rdbisch/cs498_final_project/3078-05.jpg

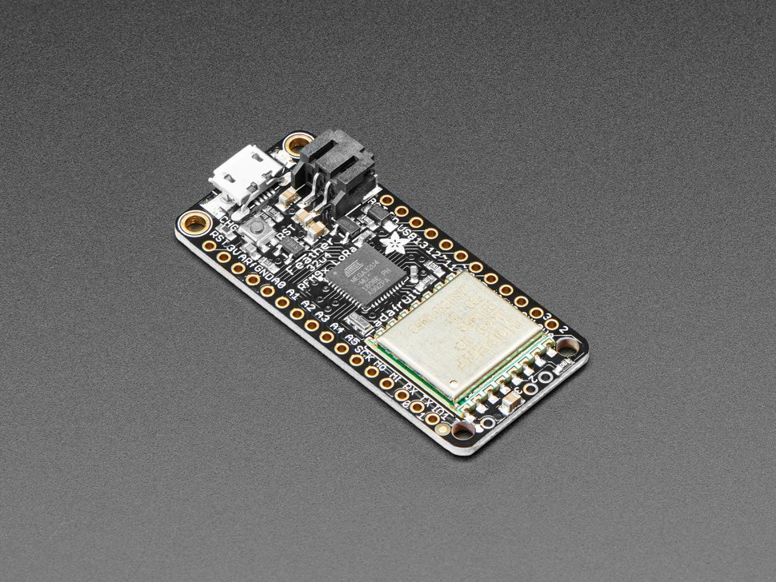
3078-05.jpg
