rdbisch/cs498_final_project/169-06.jpg

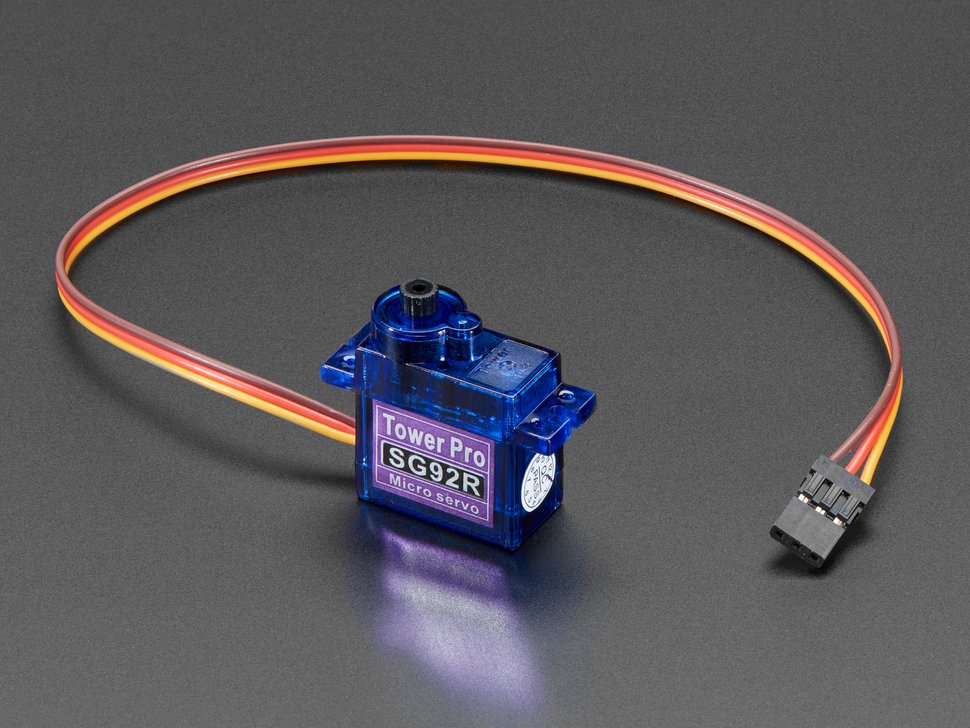
169-06.jpg
