rdbisch/cs498_final_project/data/README.md

Required directory for thermostat data logging.
