rdbisch/cs498_final_project/20210511_071446_thumb.png

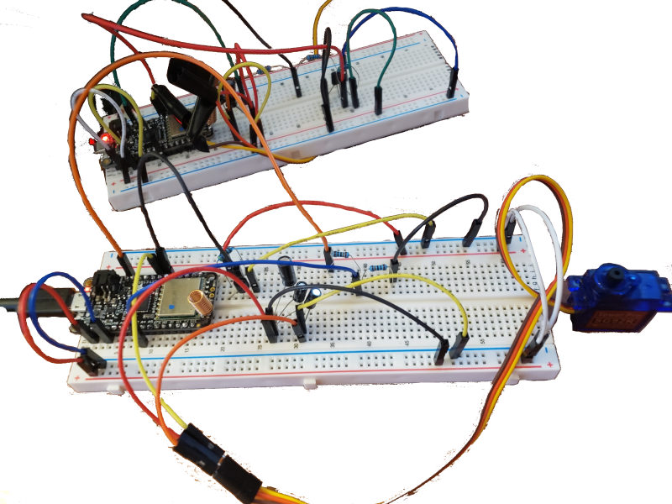
20210511_071446_thumb.png
