rdbisch/cs498_final_project/20210511_173217.jpg

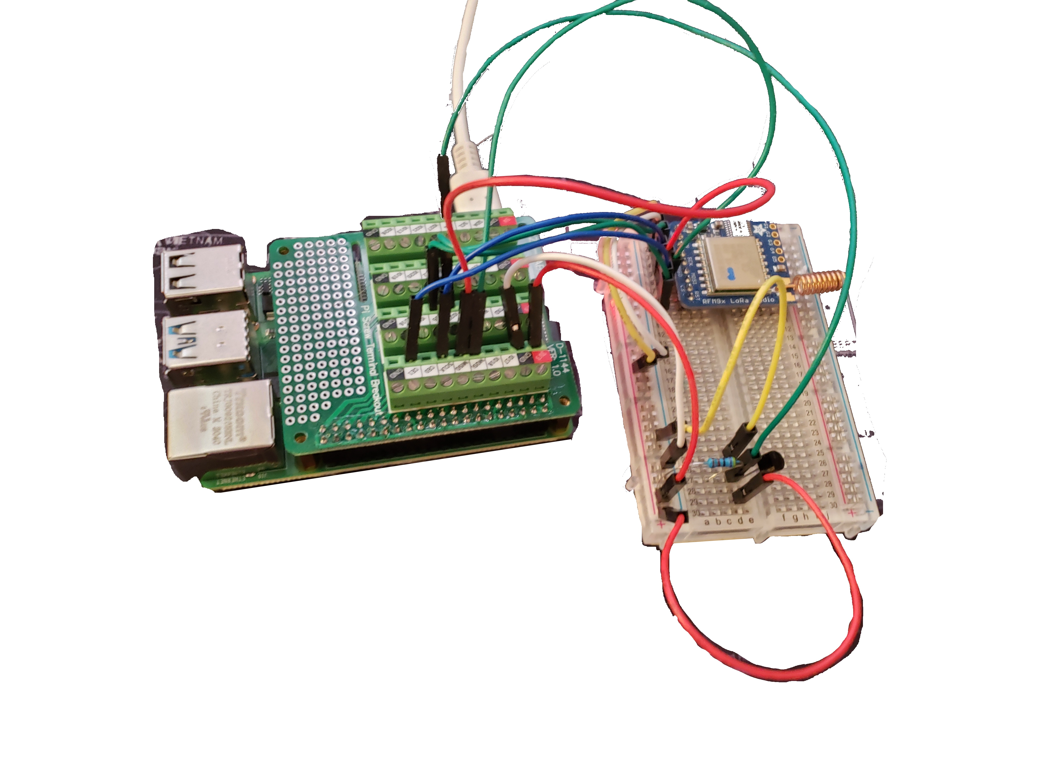
20210511_173217.jpg
