rdbisch/cs498_final_project/AltForcedAir.png

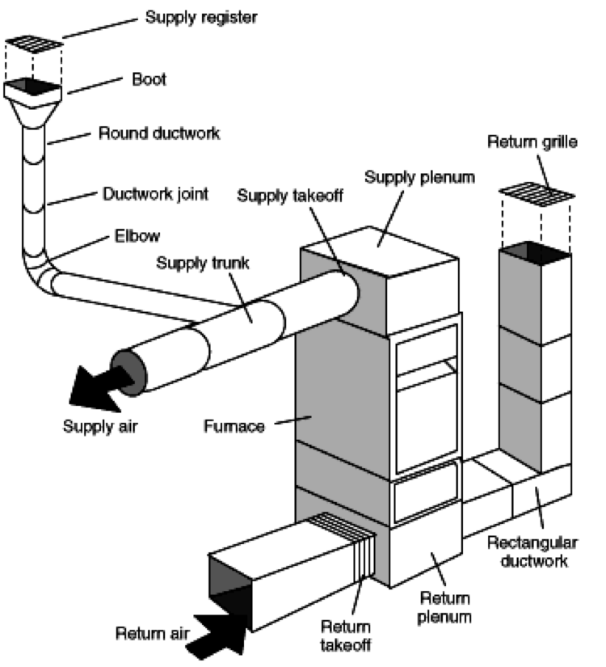
AltForcedAir.png
