rdbisch/cs498_final_project/analysis/no_corr.png

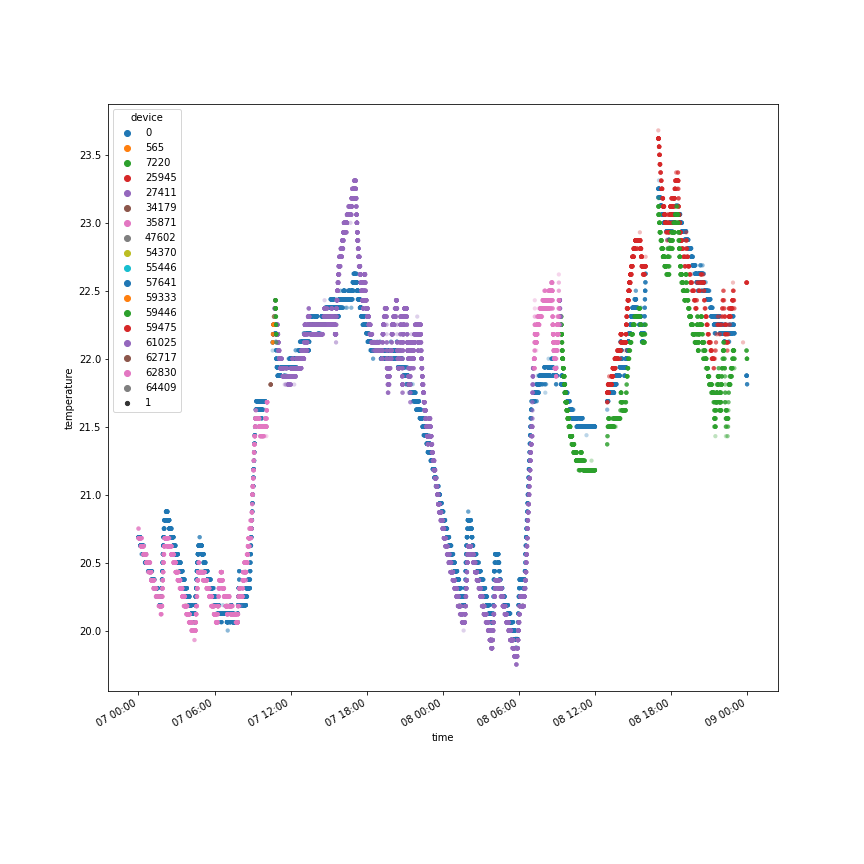
analysis/no_corr.png
