rdbisch/cs498_final_project/analysis/slow_change.png

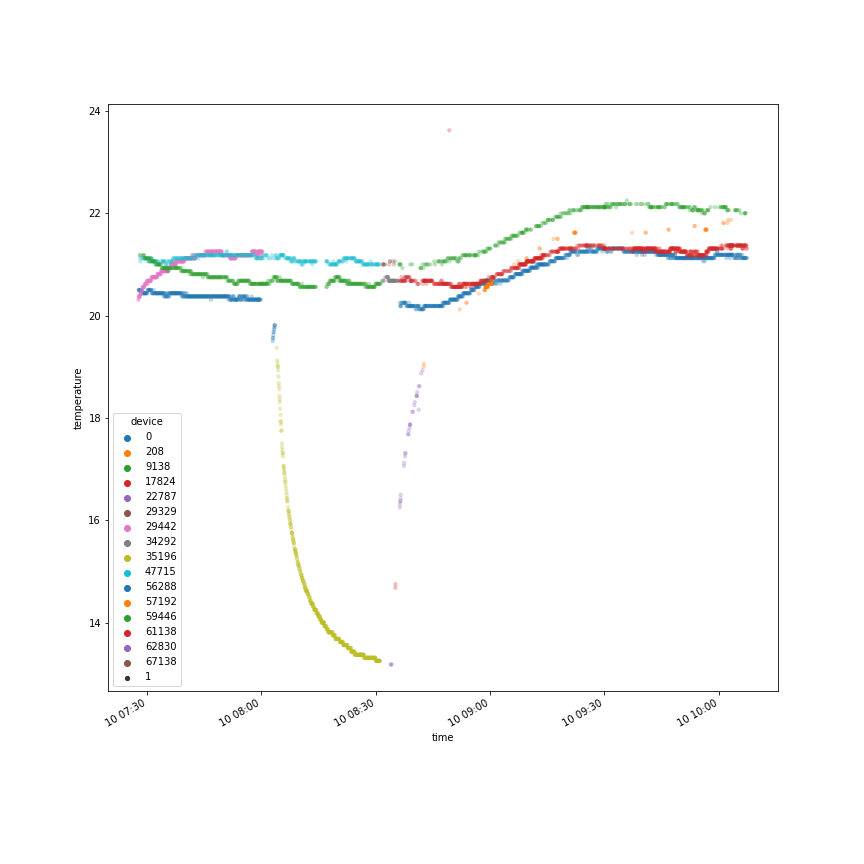
analysis/slow_change.png
