rdbisch/cs498_final_project/arduino_schematic.PNG

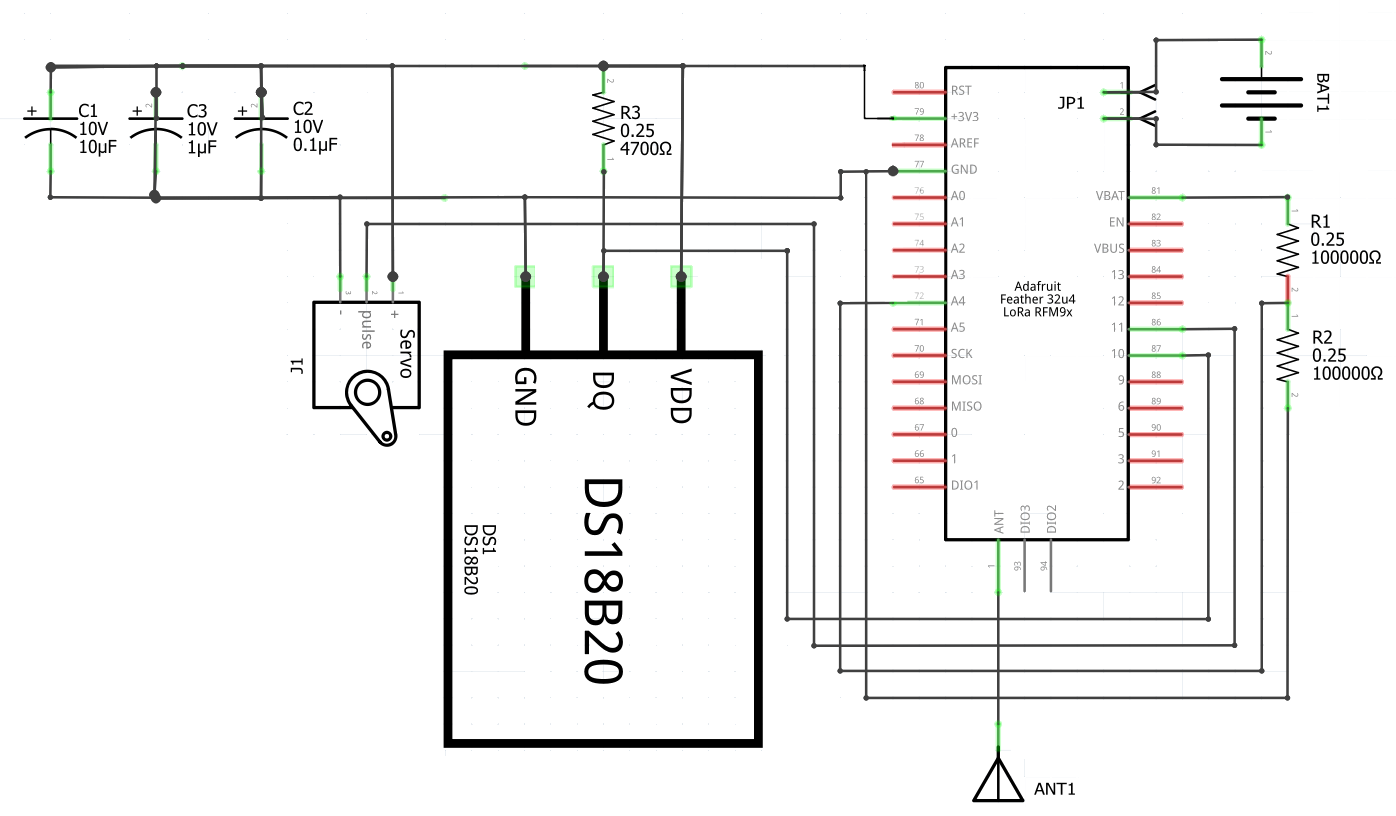
arduino_schematic.PNG
