rdbisch/cs498_final_project/overview.png

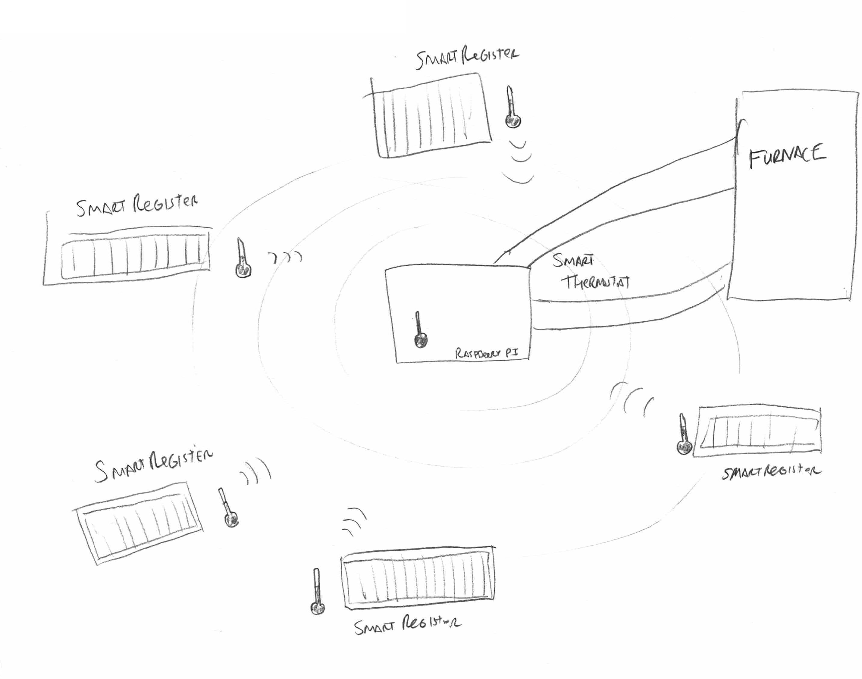
overview.png
