rdbisch/cs498_final_project/tempSensor.png

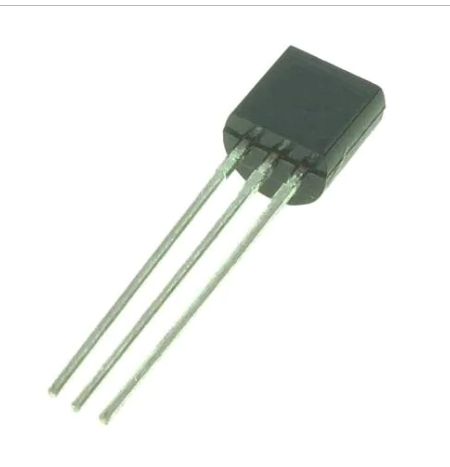
tempSensor.png
