rdbisch/cs498_final_project/(list of files, drawings)

Other design files:
arduino circuit.fzz
raspberry pi circuit.fzz
