rdbisch/cs498_final_project/exteral_code/arduino/pct2075_test.ino

#include <Adafruit_PCT2075.h>


Adafruit_PCT2075 PCT2075;

void setup() {
  PCT2075 = Adafruit_PCT2075();

  Serial.begin(115200);
  // Wait until serial port is opened
  while (!Serial) { delay(1); }
  Serial.println("Adafruit PCT2075 Test");

  while (1) {
    if (!PCT2075.begin()) {
      Serial.println("Couldn't find PCT2075 chip");
      delay(1000);
    } else {
      Serial.println("Fantastic!");
      break;
    }
  }
  
  Serial.println("Found PCT2075 chip");

}

void loop() {
  Serial.print("Temperature: "); Serial.print(PCT2075.getTemperature());Serial.println(" C");
  delay(1000);
}
