rdbisch/cs498_final_project/(commit log)

2021-04-29 syncing arduino dev pc
2021-05-06 removed spurior driver print
2021-05-07 bug fixes in driver radio
    [driver.ino]
2021-05-07 debug client radio which uncovered bugs on server radio
    [Radio.py, Thermostat.py]
2021-05-08 added voltage tracking
2021-05-08 added voltage
2021-05-10 fritzing artifacts, format changes on driver
    [arduino circuit.fzz, raspberry pi circuit.fzz]
2021-05-11 Added rough analysis and some bug fixes to driver.
    [driver.ino]
2021-05-15 last minute bug fixes for live demo
    [Radio.py, Thermostat.py]
